south2/BI2-0.1/README.md

# BI2-0.1
body interaction 2 vibrator development board (version 0.1)

www.bodyinteraction.org
