south2/BI2-0.1/p2 020.brd

## EAGLE design p2 020.brd (2018-12-07)

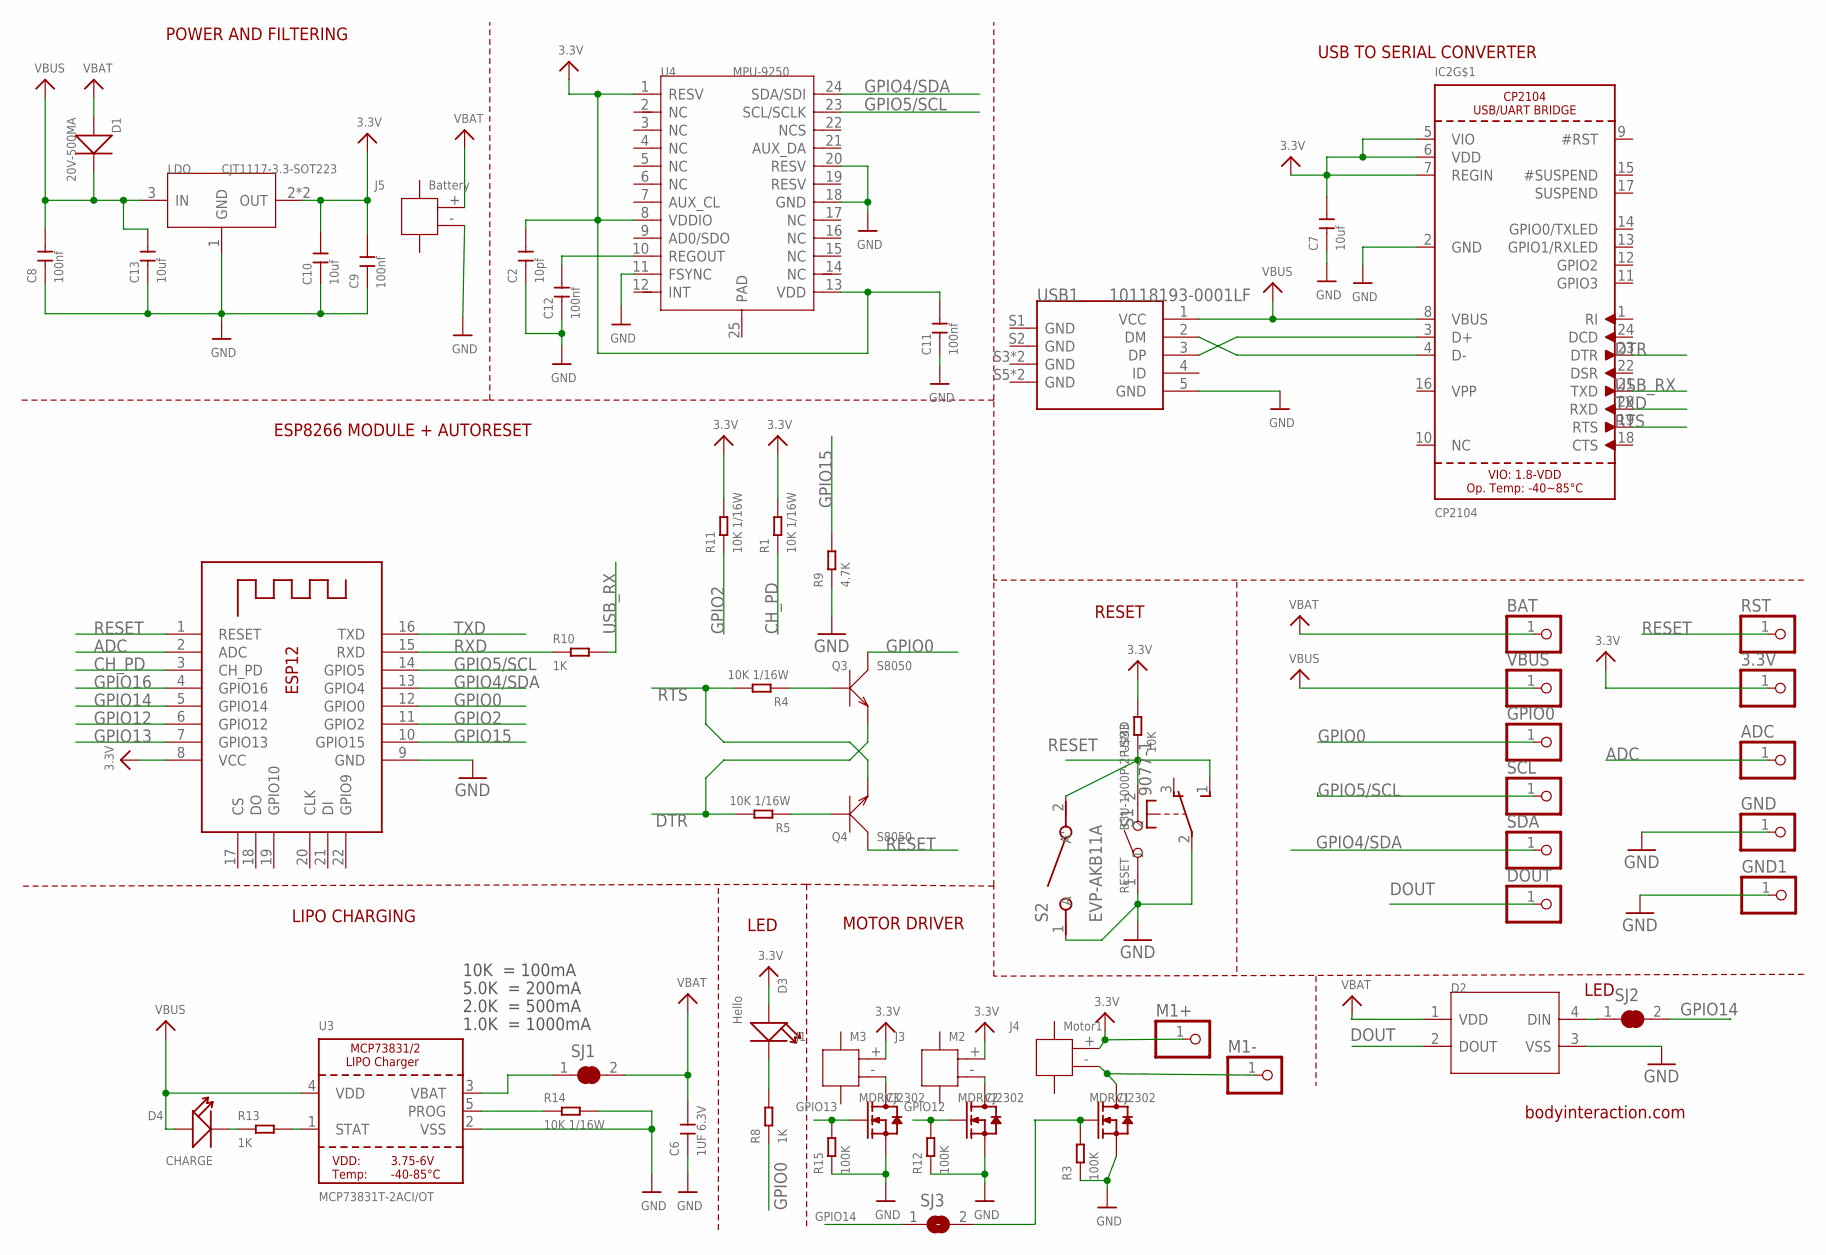
[picture p1: schematic p2 020.sch]

Parts:
3.3V: PINHD-1X1; 1X01
ADC: PINHD-1X1; 1X01
BAT: PINHD-1X1; 1X01
C2: 10pf; C0402
C6: 1UF 6.3V; C0402
C7, C10, C13: 10uf; C0402
C8, C9, C11, C12: 100nf; C0402
D1: 20V-500MA; SOD-123
D2: SMD-RGB-LED-4P'WS2812B'; LED4-SMD-5050
D3: Hello; LED-0603
D4: CHARGE; LED-0402
DOUT: PINHD-1X1; 1X01
ESP: ESP-12; ESP-12E
GND, GND1: PINHD-1X1; 1X01
GPIO0: PINHD-1X1; 1X01
IC2: CP2104; QFN24_4MM_SMSC
J1: M3; HW2-SMD-1.0-90D
J3: M2; HW2-SMD-1.0-90D
J4: Motor1; HW2-SMD-1.0-90D
J5: Battery; HW2-SMD-1.0-90D
LDO: CJT1117-3.3-SOT223; SOT-223
M1+, M1-: PINHD-1X1; 1X01
MDRV1, MDRV2, MDRV3: CJ2302; SOT-23
Q3, Q4: S8050; SOT-23
R1, R4, R5, R11, R14: 10K 1/16W; R0402
R3, R12, R15: 100K; R0402
R8, R10, R13: 1K; R0402
R9: 4.7K; R0402
RESET: B3U-1000P-2P-SMD; SW2-2.6-3.0X2.5X1.2+0.4MM
RST: PINHD-1X1; 1X01
S1: 9077-1
S2: EVP-AKB11A; SW_EVP-AKB11A
SCL: PINHD-1X1; 1X01
SDA: PINHD-1X1; 1X01
SJ1, SJ2: SOLDERJUMPER_CLOSED; SOLDERJUMPER_CLOSEDWIRE
SJ3: SJ
U3: MCP73831T-2ACI/OT; SOT23-5
U4: MPU-9250; QFN24G-0.4-3X3MM
U$33: 10K; R0402
USB1: 10118193-0001LF; MICRO-USB5+6P-SMD-0.65-B
VBUS: PINHD-1X1; 1X01

Connections:
3.3V: 3.3V.1, C2.2, C7.2, C9.2, C10.2, C11.2, D3.+, ESP.8 (VCC), IC2.5 (VIO), IC2.6 (VDD), IC2.7 (REGIN), J1.+ (1), J3.+ (1), J4.+ (1), LDO.2 (OUT), LDO.TER (OUT), M1+.1, R1.2, R11.2, U4.1 (RESV), U4.8 (VDDIO), U4.13 (VDD), U$33.2
ADC: ADC.1, ESP.2 (ADC)
CH_PD: ESP.3 (CH_PD), R1.1
DOUT: D2.2 (DOUT), DOUT.1
DTR: IC2.23 (DTR), Q3.2 (E), R5.2
GND: C2.1, C6.1, C7.1, C8.1, C9.1, C10.1, C11.1, C12.1, C13.1, D2.3 (VSS), ESP.9 (GND), GND.1, GND1.1, IC2.2 (GND), J5.- (2), LDO.1 (GND), MDRV1.2 (S), MDRV2.2 (S), MDRV3.2 (S), R3.1, R9.1, R12.1, R14.2, R15.1, RESET.1, S1.2, S2.1 (A), U3.2 (VSS), U4.11 (FSYNC), U4.18 (GND), U4.20 (RESV), USB1.5 (GND)
GPIO0: ESP.12 (GPIO0), GPIO0.1, Q3.3 (C), R8.1
GPIO2: ESP.11 (GPIO2), R11.1
GPIO4/SDA: ESP.13 (GPIO4), SDA.1, U4.24 (SDA/SDI)
GPIO5/SCL: ESP.14 (GPIO5), SCL.1, U4.23 (SCL/SCLK)
GPIO12: ESP.6 (GPIO12), MDRV2.1 (G), R12.2
GPIO13: ESP.7 (GPIO13), MDRV3.1 (G), R15.2
GPIO14: ESP.5 (GPIO14), SJ2.2, SJ3.1
GPIO15: ESP.10 (GPIO15), R9.2
GPIO16: ESP.4 (GPIO16)
unnamed: J3.- (2), MDRV2.3 (D)
unnamed: D4.-, R13.1
unnamed: J4.- (2), M1-.1, MDRV1.3 (D)
unnamed: IC2.3 (D+), USB1.3 (DP)
unnamed: D3.-, R8.2
unnamed: D2.4 (DIN), SJ2.1
unnamed: IC2.4 (D-), USB1.2 (DM)
unnamed: MDRV1.1 (G), R3.2, SJ3.2
unnamed: C12.2, U4.10 (REGOUT)
unnamed: Q4.1 (B), R5.1
unnamed: Q3.1 (B), R4.1
unnamed: R13.2, U3.1 (STAT)
unnamed: R14.1, U3.5 (PROG)
unnamed: SJ1.1, U3.3 (VBAT)
unnamed: J1.- (2), MDRV3.3 (D)
RESET: ESP.1 (RESET), Q4.3 (C), RESET.2, RST.1, S1.1 (S), S2.2 (A'), U$33.1
RTS: IC2.19 (RTS), Q4.2 (E), R4.2
RXD: ESP.15 (RXD), R10.1
TP: IC2.THERM (TP)
TXD: ESP.16 (TXD), IC2.20 (RXD)
USB_RX: IC2.21 (TXD), R10.2
VBAT: BAT.1, C6.2, D1.+, D2.1 (VDD), J5.+ (1), SJ1.2
VBUS: C8.2, C13.2, D1.-, D4.+, IC2.8 (VBUS), LDO.3 (IN), U3.4 (VDD), USB1.1 (VCC), VBUS.1

Notes on the sheet:
POWER AND FILTERING
RESET
USB TO SERIAL CONVERTER
LIPO CHARGING
LED
ESP8266 MODULE + AUTORESET
bodyinteraction.com
10K = 100mA
5.0K = 200mA
2.0K = 500mA
1.0K = 1000mA
MOTOR DRIVER

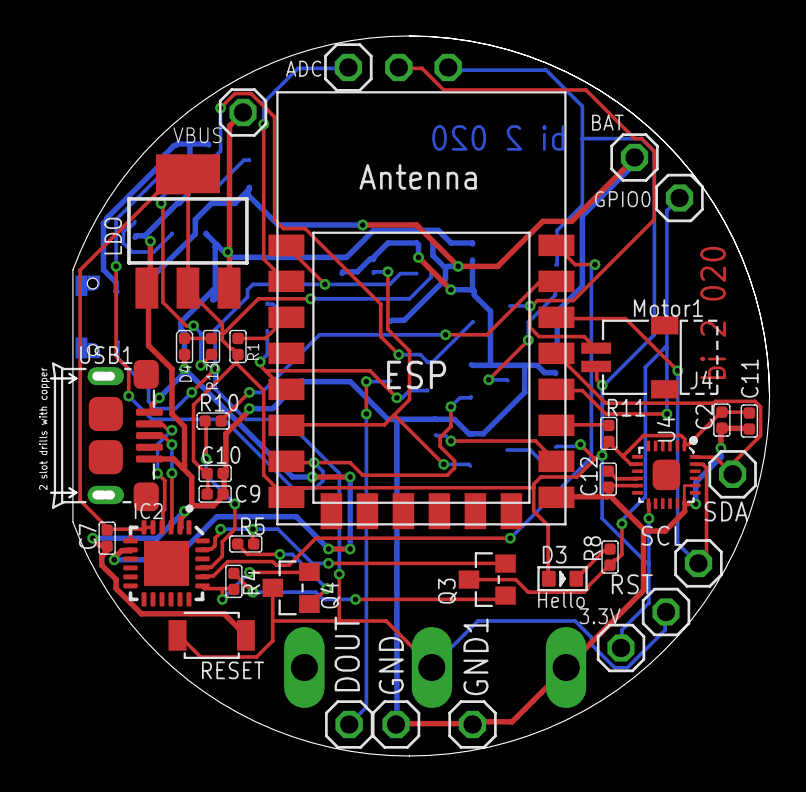
[picture p2: board p2 020.brd from above]

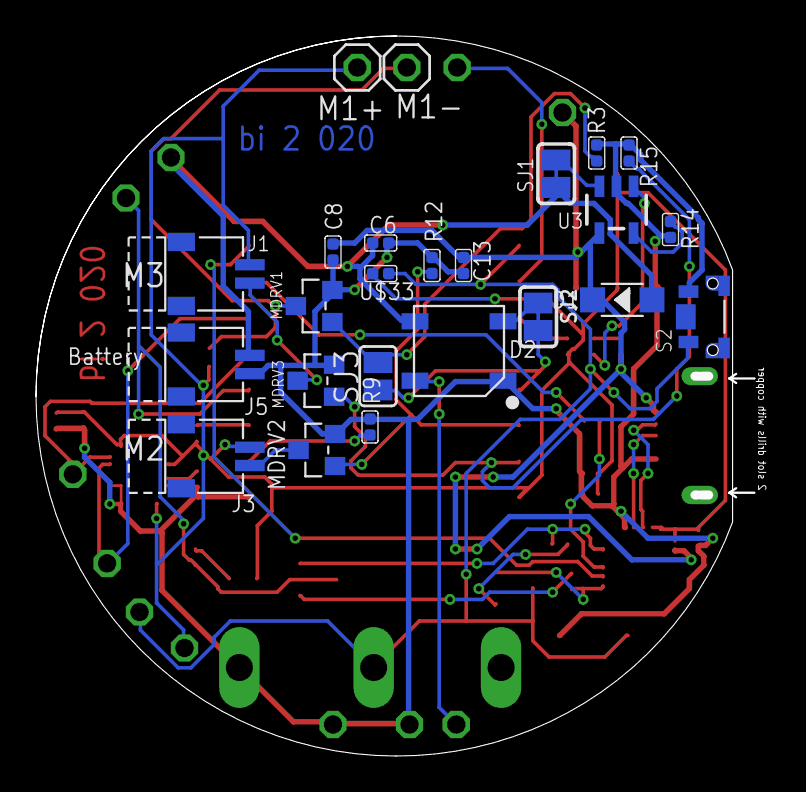
[picture p3: board p2 020.brd from below]

Board: 2 copper layers, 39.9 x 40.0 mm, 60 parts (24 on the bottom side), 36 nets.
