south2/BI2-0.1/(threads)

Thread 1 (2021-08-08):

Not charging

ArcAIN6, 2021-08-08:
Since the tindoe store states you don't ship to the US, i built one.
However, there seems to be an issue with charging

Issues:
1) The device will run indefinately until the battery is completely dead There's no way, short of disconnecting the battery, to turn the device completely off.

2) After the battery is charged, the charge IC shuts off, and doesn't turn back on charging until the device is removed from charge, and returned to charger after some amount of battery has been drained.

This leads to a catch situation, as leaving the device off the charger completely drains the battery, and leaving it on the charger will charge it to full, then never resumes charging as the battery is drained, because the device simply doesn't power off.
Using software to try to power off the device is also a no-go, as you only have stand-by modes, not a complete power off, so the device will wake up from time to time, and drain a bit more battery, eventually depleting the battery all together.

Now comes the fun bit..
Once the battery is sufficiently depleted, the device cannot charge, as all available power is being used to power the device (which will not shut off) and no  current gets to the battery, thus, once the battery is flat, it will never charge again from this circuit.

i'm wondering if a full tilt PMIC wouldn't be a better solution for this application.

Closed 2021-08-13.
